devannsa-1022/rv32i-soc-rtl-to-gds/(commit log)

2026-11-06 Import MiniSoC RV32I SoC into clean repo layout
    Move RTL, UVM/directed testbenches, program generator and FPGA
    collateral out of the Vivado project tree into rtl/, tb/, sw/, fpga/.
    Sources are unchanged. Add filelists, a script that recreates the
    Vivado project from them, and a batch UVM runner.
    Verified: hello_test, basic_program_test and random_program_test
    pass in xsim with 0 UVM errors from the new layout.
    [ALU.v, Def.v, axi_lite_if.sv, axi_lite_to_simple_bus.v, axi_manager.v, branch_unit.v, bypass_unit.v, control_unit.v]
2026-11-06 Move instruction and data memory to synchronous SRAMs
    Prepare the SoC for an ASIC flow with SRAM macros:
    - Add sram_32x256_1rw1r, a behavioral model matching the OpenRAM
    sky130_sram_1kbyte_1rw1r_32x256_8 ports and timing.
    - Move instruction memory out of the core into rv32i_soc. The core
    now drives imem_addr with the next PC so the registered SRAM output
    lines up with pc_out; fetch timing is unchanged.
    - Add an instruction-memory program-load port at the SoC top.
    - Back data memory with the same SRAM; the AXI-Lite bridge already
    holds the read address into R_RESP, so no bridge change is needed.
    - Make UART CLK_FREQ/BAUD_RATE SoC parameters (default 50 MHz/115200);
    testbenches keep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
2026-11-07 Add OpenROAD flow setup and first sky130hd synthesis
    - flow/config.mk: ORFS design config for rv32i_soc on sky130hd. RTL
    comes from rtl/rtl.f; the SRAM model is a synthesis black box until
    the sky130 macros are integrated.
    - flow/constraint.sdc: 20 ns clock with uncertainty, I/O delays
    against a virtual clock, input driving cell, output load.
    - flow/run.sh: runs ORFS targets in the openroad/orfs Docker image with
    the repo mounted read-only and outputs in ~/rv32i_orfs_work.
    - Drop INIT_FILE from the SRAM model so it has no parameters, like the
    macro. The parameter made Yosys rename the module and skip the black
    box. The FPGA core wrapper now exposes the program-load port instead.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
    [control_unit.v, instruction_memory.v, rv32i_core_synth_top.v, sram_32x256_1rw1r.v]
2026-11-07 Integrate SKY130 SRAM macros and build the first floorplan
    - Add sky130_sram_1kbyte_1rw1r_32x256_8 (LEF, LIB, GDS, Verilog) from
    VLSIDA/sky130_sram_macros @965df15, Apache-2.0.
    - sram_32x256_1rw1r: instantiate the macro under USE_SRAM_MACRO. Make
    the behavioral model match the macro: read data is valid only in the
    cycle after a read and is X otherwise.
    - axi_lite_to_simple_bus: keep the data SRAM selected through R_RESP.
    The bridge re-samples read data while it waits for rready; with the
    macro's real output behavior that sampled X (7 basic_program_test
    register checks failed with the accurate model).
    - Flow: macro LEF/LIB/GDS in config.mk, explicit die/core, manual macro
    placem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
    [axi_lite_to_simple_bus.v, data_mem.v, sram_32x256_1rw1r.v]
2026-11-10 Complete the baseline run to GDS and record its metrics
    Place, CTS, route and finish run with default ORFS settings on the step 5
    floorplan. Timing closes at 20 ns (WNS +8.19 ns, hold +0.12 ns, minimum
    period 11.81 ns), with 0 detailed-route DRC and 0 antenna violations.
    The README records the baseline metrics table, the critical path
    (register-file read -> branch compare -> next-PC select -> instruction
    SRAM address), the SRAM max-slew waiver (OpenRAM Liberty characterized
    only to 40 ps input slew), and the final and placement layout images.
